JeremiahWu/RoboWheels/ros2_ws/src/robowheels_description/meshes/base_link.stl

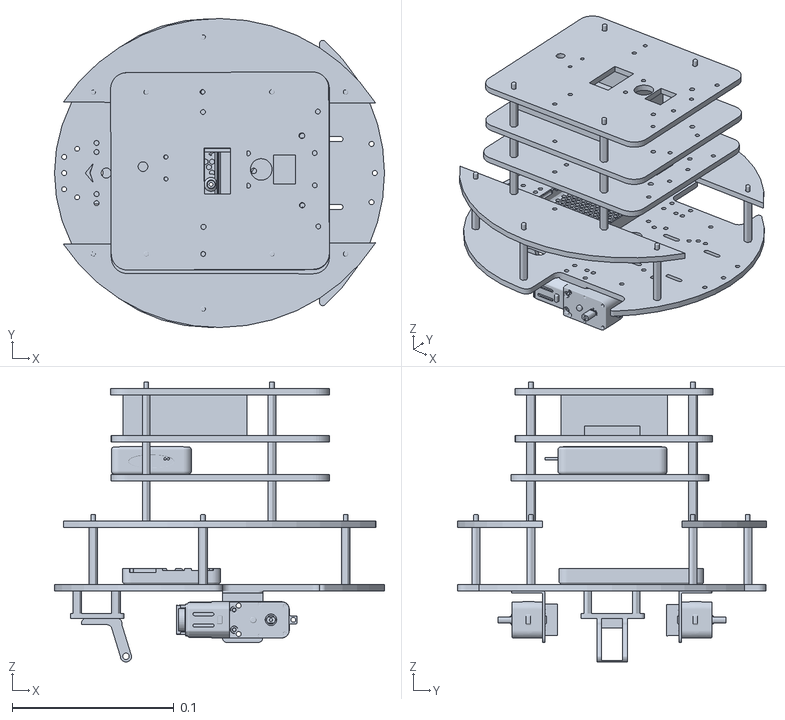
[picture p2: CAD file, 2026-11-05]
ros2_ws/src/robowheels_description/meshes/base_link.stl
0.204 x 0.191 x 0.173
