JeremiahWu/RoboWheels/ros2_ws/src/robowheels_description/meshes/arm_mount_link.stl

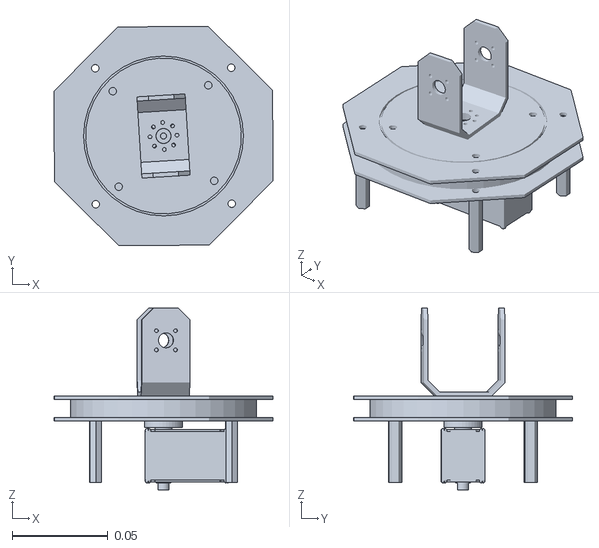
[picture p3: CAD file, 2026-11-05]
ros2_ws/src/robowheels_description/meshes/arm_mount_link.stl
0.114 x 0.114 x 0.0948
