JeremiahWu/RoboWheels/ros2_ws/src/robowheels_description/meshes/caster_link.stl

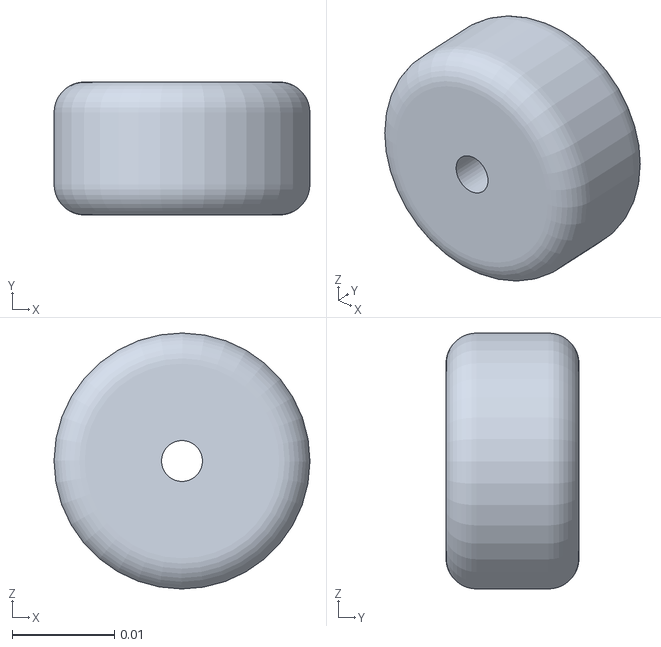
[picture p4: CAD file, 2026-11-05]
ros2_ws/src/robowheels_description/meshes/caster_link.stl
0.025 x 0.013 x 0.025
