JeremiahWu/RoboWheels/ros2_ws/src/robowheels_description/meshes/left_elbow_pitch_link.stl

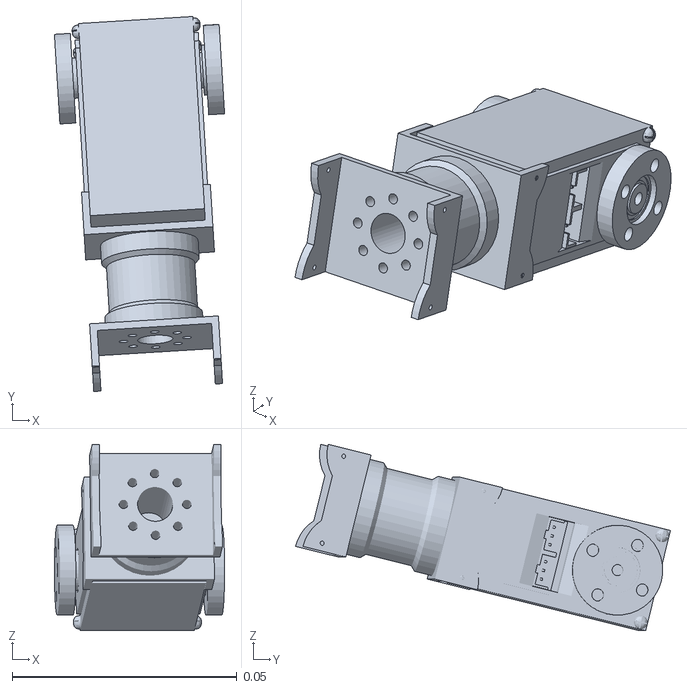
[picture p5: CAD file, 2026-11-05]
ros2_ws/src/robowheels_description/meshes/left_elbow_pitch_link.stl
0.0379 x 0.0835 x 0.0414
