JeremiahWu/RoboWheels/ros2_ws/src/robowheels_description/meshes/mast_link.stl

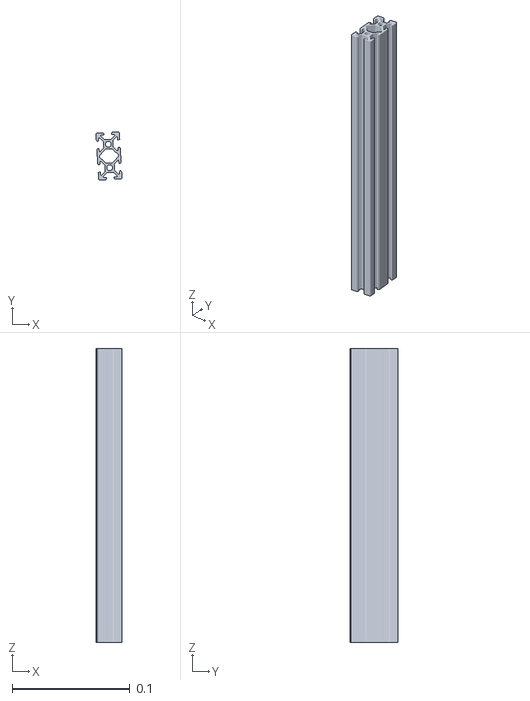
[picture p6: CAD file, 2026-11-05]
ros2_ws/src/robowheels_description/meshes/mast_link.stl
0.0223 x 0.041 x 0.25
