JeremiahWu/RoboWheels/ros2_ws/src/robowheels_description/meshes/right_wheel_link.stl

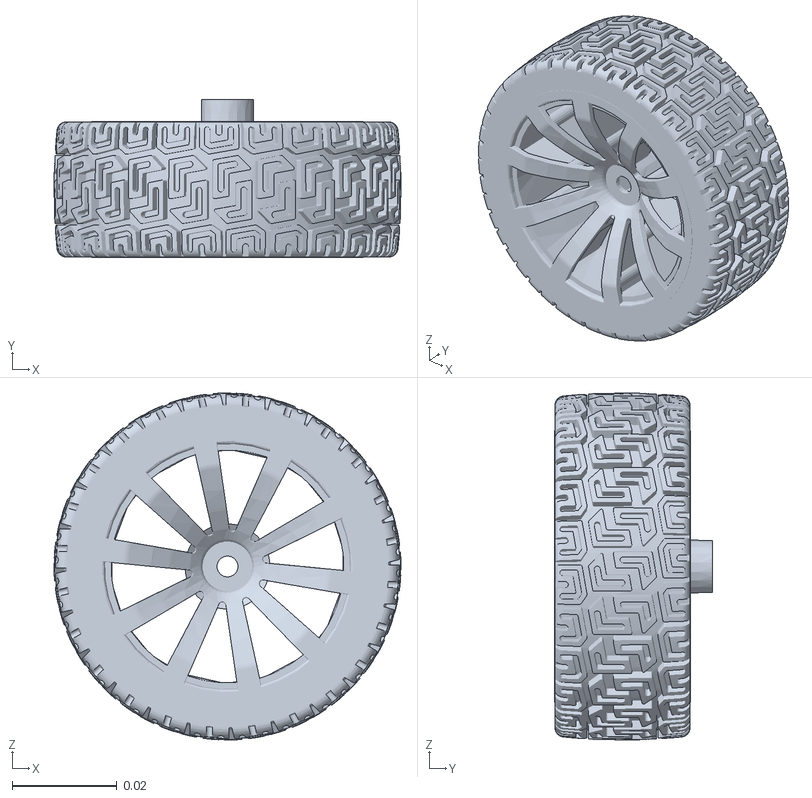
[picture p7: CAD file, 2026-11-05]
ros2_ws/src/robowheels_description/meshes/right_wheel_link.stl
0.0664 x 0.0302 x 0.0664
