JeremiahWu/RoboWheels/ros2_ws/src/robowheels_description/meshes/right_wrist_pitch_link.stl

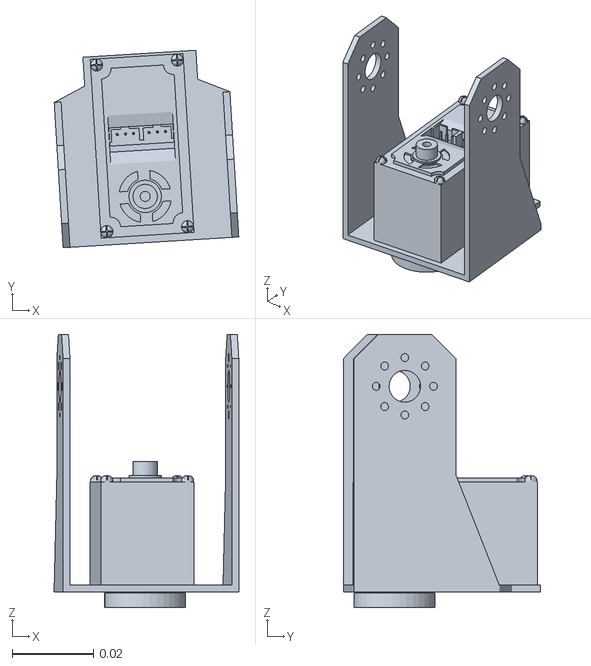
[picture p8: CAD file, 2026-11-05]
ros2_ws/src/robowheels_description/meshes/right_wrist_pitch_link.stl
0.0455 x 0.0487 x 0.0673
