JeremiahWu/RoboWheels/ros2_ws/src/robowheels_description/meshes/right_shoulder_roll_link.stl

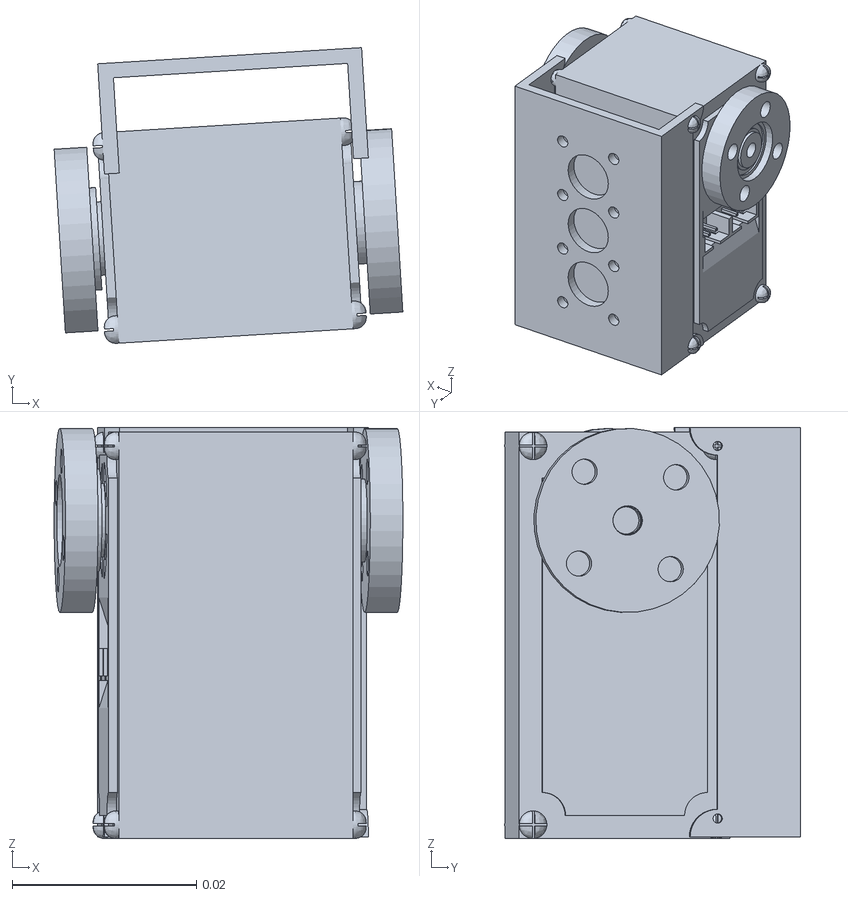
[picture p9: CAD file, 2026-11-05]
ros2_ws/src/robowheels_description/meshes/right_shoulder_roll_link.stl
0.0379 x 0.0321 x 0.0447
