JeremiahWu/RoboWheels/ros2_ws/src/robowheels_description/meshes/left_arm_link.stl

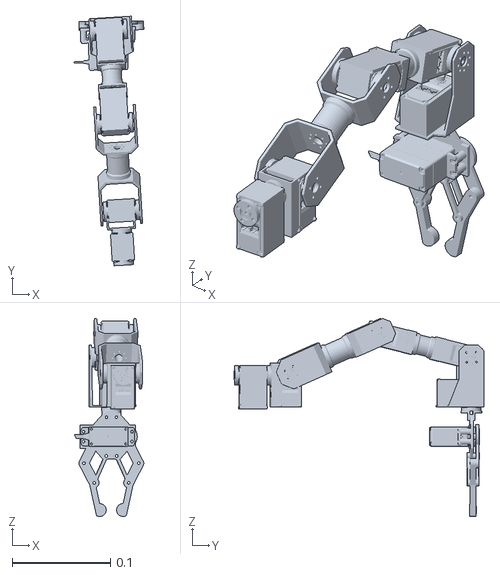
[picture p10: CAD file, 2026-11-05]
ros2_ws/src/robowheels_description/meshes/left_arm_link.stl
0.071 x 0.254 x 0.202
