JeremiahWu/RoboWheels/ros2_ws/src/robowheels_description/meshes/astra_link.stl

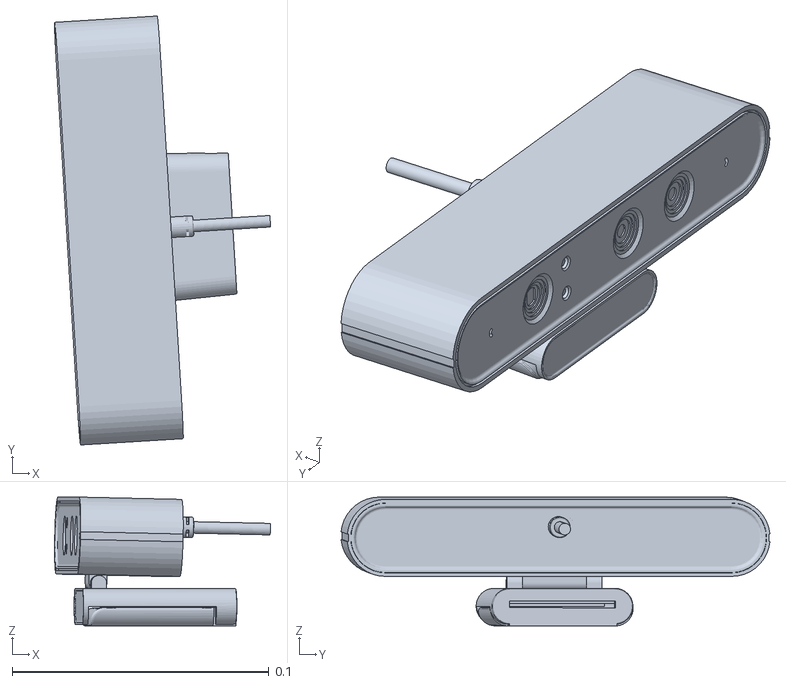
[picture p11: CAD file, 2026-11-05]
ros2_ws/src/robowheels_description/meshes/astra_link.stl
0.0841 x 0.167 x 0.0502
