JeremiahWu/RoboWheels/ros2_ws/src/robowheels_description/meshes/right_wrist_roll_link.stl

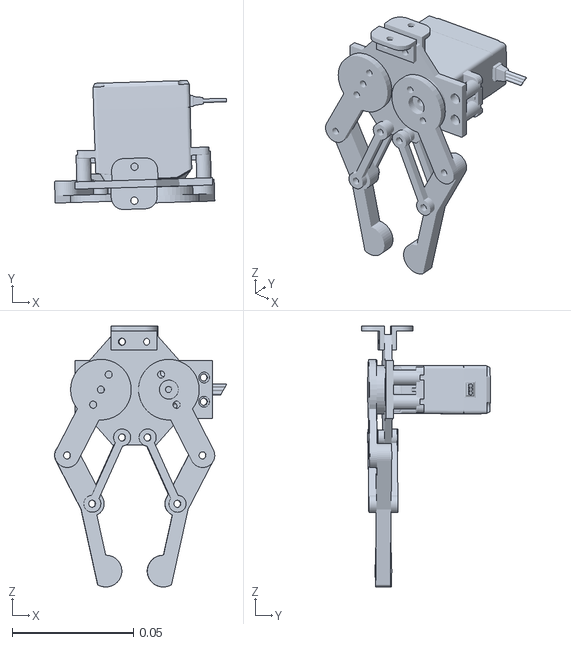
[picture p12: CAD file, 2026-11-05]
ros2_ws/src/robowheels_description/meshes/right_wrist_roll_link.stl
0.071 x 0.0532 x 0.108
