JeremiahWu/RoboWheels/ros2_ws/src/robowheels_description/meshes/left_shoulder_pitch_link.stl

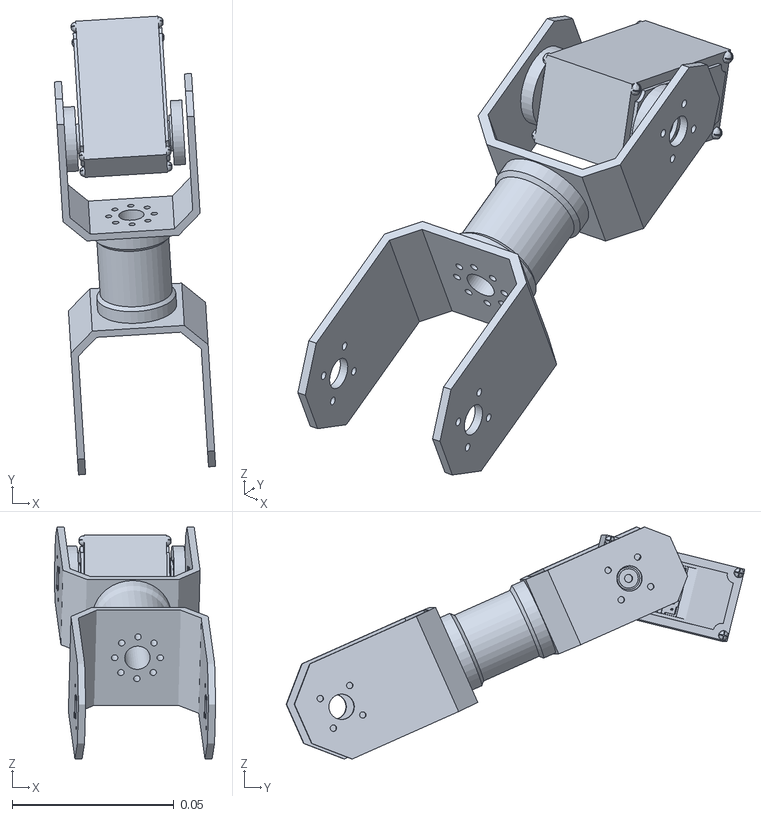
[picture p13: CAD file, 2026-11-05]
ros2_ws/src/robowheels_description/meshes/left_shoulder_pitch_link.stl
0.0499 x 0.142 x 0.0717
