JeremiahWu/RoboWheels/ros2_ws/src/robowheels_description/meshes/shoulder_housings_link.stl

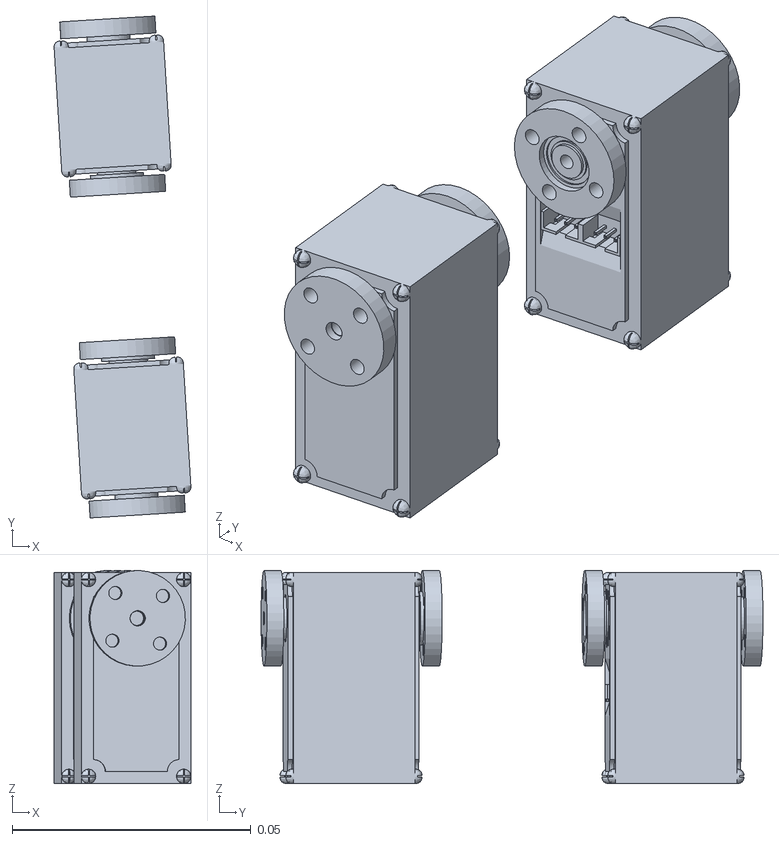
[picture p14: CAD file, 2026-11-05]
ros2_ws/src/robowheels_description/meshes/shoulder_housings_link.stl
0.0286 x 0.105 x 0.0446
