JeremiahWu/RoboWheels/(list of files, cad)

Other CAD files:
ros2_ws/src/robowheels_description/meshes/right_elbow_pitch_link.stl
ros2_ws/src/robowheels_description/meshes/left_wrist_pitch_link.stl
ros2_ws/src/robowheels_description/meshes/left_wrist_roll_link.stl
ros2_ws/src/robowheels_description/meshes/left_wheel_link.stl
ros2_ws/src/robowheels_description/meshes/right_shoulder_pitch_link.stl
ros2_ws/src/robowheels_description/meshes/left_shoulder_roll_link.stl
ros2_ws/src/robowheels_description/meshes/right_arm_link.stl
