JeremiahWu/RoboWheels/ros2_ws/src/robowheels_description/urdf/robot.sdf

<?xml version='1.0' encoding='utf-8'?>
<sdf version="1.9">
  <model name="robowheels">
    <link name="base_footprint">
      <inertial>
        <pose>-0.01786885333849206 0.001435441879079369 0.2251637846261905 0 0 0</pose>
        <mass>3.7799999999999998</mass>
        <inertia>
          <ixx>0.121327478935251</ixx>
          <ixy>0.0026274709799714458</ixy>
          <ixz>-0.0078314570425474274</ixz>
          <iyy>0.092691720102476158</iyy>
          <iyz>-0.00069924493382175355</iyz>
          <izz>0.045640601307076777</izz>
        </inertia>
      </inertial>
      <collision name="base_footprint_fixed_joint_lump__base_link_collision_collision">
        <pose>-0.0318259535 3.65871519e-05 0.0936680357 0 0 0</pose>
        <geometry>
          <box>
            <size>0.204 0.191015 0.173</size>
          </box>
        </geometry>
        <surface>
          <contact>
            <ode />
          </contact>
          <friction>
            <ode>
              <mu>0.80000000000000004</mu>
              <mu2>0.80000000000000004</mu2>
            </ode>
          </friction>
        </surface>
      </collision>
      <collision name="base_footprint_fixed_joint_lump__arm_mount_link_collision_collision_1">
        <pose>-0.00637300074 0.0023598377 0.219723035 0 0 0</pose>
        <geometry>
          <box>
            <size>0.114373 0.114373 0.09481</size>
          </box>
        </geometry>
        <surface>
          <contact>
            <ode />
          </contact>
          <friction>
            <ode>
              <mu>0.80000000000000004</mu>
              <mu2>0.80000000000000004</mu2>
            </ode>
          </friction>
        </surface>
      </collision>
      <collision name="base_footprint_fixed_joint_lump__astra_link_collision_collision_2">
        <pose>0.00857200063 0.00332180294 0.49856978 0 0 0</pose>
        <geometry>
          <box>
            <size>0.084083 0.166992 0.050164</size>
          </box>
        </geometry>
        <surface>
          <contact>
            <ode />
          </contact>
          <friction>
            <ode>
              <mu>0.80000000000000004</mu>
              <mu2>0.80000000000000004</mu2>
            </ode>
          </friction>
        </surface>
      </collision>
      <collision name="base_footprint_fixed_joint_lump__caster_link_collision_collision_3">
        <pose>-0.08965176010000001 0.00013640945 0.01249999998 0 0 0</pose>
        <geometry>
          <sphere>
            <radius>0.012500000000000001</radius>
          </sphere>
        </geometry>
        <surface>
          <contact>
            <ode />
          </contact>
          <friction>
            <ode>
              <mu>0.01</mu>
              <mu2>0.01</mu2>
            </ode>
          </friction>
        </surface>
      </collision>
      <collision name="base_footprint_fixed_joint_lump__left_arm_link_collision_collision_4">
        <pose>-0.0219609873 0.144534971 0.345362959 0 0 0</pose>
        <geometry>
          <box>
            <size>0.070983 0.254439 0.2018</size>
          </box>
        </geometry>
        <surface>
          <contact>
            <ode />
          </contact>
          <friction>
            <ode>
              <mu>0.80000000000000004</mu>
              <mu2>0.80000000000000004</mu2>
            </ode>
          </friction>
        </surface>
      </collision>
      <collision name="base_footprint_fixed_joint_lump__mast_link_collision_collision_5">
        <pose>-0.00625268749 0.00269514236 0.348488035 0 0 0</pose>
        <geometry>
          <box>
            <size>0.022292 0.04103 0.25</size>
          </box>
        </geometry>
        <surface>
          <contact>
            <ode />
          </contact>
          <friction>
            <ode>
              <mu>0.80000000000000004</mu>
              <mu2>0.80000000000000004</mu2>
            </ode>
          </friction>
        </surface>
      </collision>
      <collision name="base_footprint_fixed_joint_lump__right_arm_link_collision_collision_6">
        <pose>0.0098113317 -0.139122875 0.345362959 0 0 0</pose>
        <geometry>
          <box>
            <size>0.070983 0.254439 0.2018</size>
          </box>
        </geometry>
        <surface>
          <contact>
            <ode />
          </contact>
          <friction>
            <ode>
              <mu>0.80000000000000004</mu>
              <mu2>0.80000000000000004</mu2>
            </ode>
          </friction>
        </surface>
      </collision>
      <visual name="base_footprint_fixed_joint_lump__base_link_visual">
        <pose>0 0 0.0332 0 0 0</pose>
        <geometry>
          <mesh>
            <scale>1 1 1</scale>
            <uri>model://robowheels_description/meshes/base_link.stl</uri>
          </mesh>
        </geometry>
        <material>
          <diffuse>0.8125 0.875 0.9375 1</diffuse>
          <ambient>0.8125 0.875 0.9375 1</ambient>
        </material>
      </visual>
      <visual name="base_footprint_fixed_joint_lump__arm_mount_link_visual_1">
        <pose>-0.00637300074 0.0023598377 0.219723035 0 0 0</pose>
        <geometry>
          <mesh>
            <scale>1 1 1</scale>
            <uri>model://robowheels_description/meshes/arm_mount_link.stl</uri>
          </mesh>
        </geometry>
        <material>
          <diffuse>0.8125 0.875 0.9375 1</diffuse>
          <ambient>0.8125 0.875 0.9375 1</ambient>
        </material>
      </visual>
      <visual name="base_footprint_fixed_joint_lump__astra_link_visual_2">
        <pose>0.00857200063 0.00332180294 0.49856978 0 0 0</pose>
        <geometry>
          <mesh>
            <scale>1 1 1</scale>
            <uri>model://robowheels_description/meshes/astra_link.stl</uri>
          </mesh>
        </geometry>
        <material>
          <diffuse>0.8125 0.875 0.9375 1</diffuse>
          <ambient>0.8125 0.875 0.9375 1</ambient>
        </material>
      </visual>
      <visual name="base_footprint_fixed_joint_lump__caster_link_visual_3">
        <pose>-0.08965176010000001 0.00013640945 0.0106680359 0 0 0</pose>
        <geometry>
          <mesh>
            <scale>1 1 1</scale>
            <uri>model://robowheels_description/meshes/caster_link.stl</uri>
          </mesh>
        </geometry>
        <material>
          <diffuse>0.8125 0.875 0.9375 1</diffuse>
          <ambient>0.8125 0.875 0.9375 1</ambient>
        </material>
      </visual>
      <visual name="base_footprint_fixed_joint_lump__left_arm_link_visual_4">
        <pose>-0.0219609873 0.144534971 0.345362959 0 0 0</pose>
        <geometry>
          <mesh>
            <scale>1 1 1</scale>
            <uri>model://robowheels_description/meshes/left_arm_link.stl</uri>
          </mesh>
        </geometry>
        <material>
          <diffuse>0.8125 0.875 0.9375 1</diffuse>
          <ambient>0.8125 0.875 0.9375 1</ambient>
        </material>
      </visual>
      <visual name="base_footprint_fixed_joint_lump__mast_link_visual_5">
        <pose>-0.00625268749 0.00269514236 0.348488035 0 0 0</pose>
        <geometry>
          <mesh>
            <scale>1 1 1</scale>
            <uri>model://robowheels_description/meshes/mast_link.stl</uri>
          </mesh>
        </geometry>
        <material>
          <diffuse>0.8125 0.875 0.9375 1</diffuse>
          <ambient>0.8125 0.875 0.9375 1</ambient>
        </material>
      </visual>
      <visual name="base_footprint_fixed_joint_lump__right_arm_link_visual_6">
        <pose>0.0098113317 -0.139122875 0.345362959 0 0 0</pose>
        <geometry>
          <mesh>
            <scale>1 1 1</scale>
            <uri>model://robowheels_description/meshes/right_arm_link.stl</uri>
          </mesh>
        </geometry>
        <material>
          <diffuse>0.8125 0.875 0.9375 1</diffuse>
          <ambient>0.8125 0.875 0.9375 1</ambient>
        </material>
      </visual>
    </link>
    <joint name="left_wheel_joint" type="revolute">
      <pose relative_to="base_footprint">0 0.0781561955 0.0332 0 0 0</pose>
      <parent>base_footprint</parent>
      <child>left_wheel_link</child>
      <axis>
        <xyz>0 1 0</xyz>
        <limit>
          <effort>2</effort>
          <velocity>20</velocity>
          <lower>-10000000000000000</lower>
          <upper>10000000000000000</upper>
        </limit>
        <dynamics>
          <damping>0.01</damping>
          <friction>0</friction>
          <spring_reference>0</spring_reference>
          <spring_stiffness>0</spring_stiffness>
        </dynamics>
      </axis>
    </joint>
    <link name="left_wheel_link">
      <pose relative_to="left_wheel_joint">0 0 0 0 0 0</pose>
      <inertial>
        <pose>-3.6370024e-10 -0.000586149315 1.99372303e-10 0 0 0</pose>
        <mass>0.080000000000000002</mass>
        <inertia>
          <ixx>3.5456330816517193e-05</ixx>
          <ixy>0</ixy>
          <ixz>0</ixz>
          <iyy>5.8719812896416519e-05</iyy>
          <iyz>0</iyz>
          <izz>3.5456330816521293e-05</izz>
        </inertia>
      </inertial>
      <collision name="left_wheel_link_collision_collision">
        <pose>0 0 0 1.570796326794896 0 0</pose>
        <geometry>
          <cylinder>
            <length>0.025999999999999999</length>
            <radius>0.0332</radius>
          </cylinder>
        </geometry>
        <surface>
          <contact>
            <ode />
          </contact>
          <friction>
            <ode>
              <mu>0.80000000000000004</mu>
              <mu2>0.80000000000000004</mu2>
            </ode>
          </friction>
        </surface>
      </collision>
      <visual name="left_wheel_link_visual">
        <pose>0 0 0 0 0 0</pose>
        <geometry>
          <mesh>
            <scale>1 1 1</scale>
            <uri>model://robowheels_description/meshes/left_wheel_link.stl</uri>
          </mesh>
        </geometry>
        <material>
          <diffuse>0.15 0.15 0.175 1</diffuse>
          <ambient>0.15 0.15 0.175 1</ambient>
        </material>
      </visual>
    </link>
    <joint name="right_wheel_joint" type="revolute">
      <pose relative_to="base_footprint">0 -0.0781561955 0.0332 0 0 0</pose>
      <parent>base_footprint</parent>
      <child>right_wheel_link</child>
      <axis>
        <xyz>0 1 0</xyz>
        <limit>
          <effort>2</effort>
          <velocity>20</velocity>
          <lower>-10000000000000000</lower>
          <upper>10000000000000000</upper>
        </limit>
        <dynamics>
          <damping>0.01</damping>
          <friction>0</friction>
          <spring_reference>0</spring_reference>
          <spring_stiffness>0</spring_stiffness>
        </dynamics>
      </axis>
    </joint>
    <link name="right_wheel_link">
      <pose relative_to="right_wheel_joint">0 0 0 0 0 0</pose>
      <inertial>
        <pose>2.94291862e-10 0.000586141681 2.00216441e-10 0 0 0</pose>
        <mass>0.080000000000000002</mass>
        <inertia>
          <ixx>3.5456330816527818e-05</ixx>
          <ixy>0</ixy>
          <ixz>0</ixz>
          <iyy>5.8719812896417197e-05</iyy>
          <iyz>0</iyz>
          <izz>3.5456330816524721e-05</izz>
        </inertia>
      </inertial>
      <collision name="right_wheel_link_collision_collision">
        <pose>0 0 0 1.570796326794896 0 0</pose>
        <geometry>
          <cylinder>
            <length>0.025999999999999999</length>
            <radius>0.0332</radius>
          </cylinder>
        </geometry>
        <surface>
          <contact>
            <ode />
          </contact>
          <friction>
            <ode>
              <mu>0.80000000000000004</mu>
              <mu2>0.80000000000000004</mu2>
            </ode>
          </friction>
        </surface>
      </collision>
      <visual name="right_wheel_link_visual">
        <pose>0 0 0 0 0 0</pose>
        <geometry>
          <mesh>
            <scale>1 1 1</scale>
            <uri>model://robowheels_description/meshes/right_wheel_link.stl</uri>
          </mesh>
        </geometry>
        <material>
          <diffuse>0.15 0.15 0.175 1</diffuse>
          <ambient>0.15 0.15 0.175 1</ambient>
        </material>
      </visual>
    </link>
    <plugin name="ignition::gazebo::systems::DiffDrive" filename="libignition-gazebo-diff-drive-system.so">
      <left_joint>left_wheel_joint</left_joint>
      <right_joint>right_wheel_joint</right_joint>
      <wheel_separation>0.15631239107433037</wheel_separation>
      <wheel_radius>0.0332</wheel_radius>
      <topic>/sim/cmd_vel</topic>
      <odom_topic>/odom</odom_topic>
      <tf_topic>/tf</tf_topic>
      <frame_id>odom</frame_id>
      <child_frame_id>base_footprint</child_frame_id>
      <odom_publish_frequency>50</odom_publish_frequency>
      <max_linear_velocity>0.5</max_linear_velocity>
      <min_linear_velocity>-0.5</min_linear_velocity>
      <max_angular_velocity>2.0</max_angular_velocity>
      <min_angular_velocity>-2.0</min_angular_velocity>
    </plugin>
    <plugin name="ignition::gazebo::systems::JointStatePublisher" filename="libignition-gazebo-joint-state-publisher-system.so">
      <topic>/joint_states</topic>
      <joint_name>left_wheel_joint</joint_name>
      <joint_name>right_wheel_joint</joint_name>
    </plugin>
    <plugin name="ignition::gazebo::systems::PosePublisher" filename="libignition-gazebo-pose-publisher-system.so">
      <publish_model_pose>true</publish_model_pose>
      <publish_link_pose>false</publish_link_pose>
      <use_pose_vector_msg>true</use_pose_vector_msg>
      <update_frequency>30</update_frequency>
      <publish_nested_model_pose>true</publish_nested_model_pose>
    </plugin>
    <frame name="arm_mount_joint" attached_to="base_link">
      <pose>-0.006373 0.00236 0.186523 0 -0 0</pose>
    </frame>
    <frame name="arm_mount_link" attached_to="arm_mount_joint" />
    <frame name="astra_joint" attached_to="base_link">
      <pose>0.008572 0.003322 0.46537 0 -0 0</pose>
    </frame>
    <frame name="astra_link" attached_to="astra_joint" />
    <frame name="caster_joint" attached_to="base_link">
      <pose>-0.089652 0.000136 -0.022532 0 -0 0</pose>
    </frame>
    <frame name="caster_link" attached_to="caster_joint" />
    <frame name="left_arm_joint" attached_to="base_link">
      <pose>-0.021961 0.144535 0.312163 0 -0 0</pose>
    </frame>
    <frame name="left_arm_link" attached_to="left_arm_joint" />
    <frame name="mast_joint" attached_to="base_link">
      <pose>-0.006253 0.002695 0.315288 0 -0 0</pose>
    </frame>
    <frame name="mast_link" attached_to="mast_joint" />
    <frame name="right_arm_joint" attached_to="base_link">
      <pose>0.009811 -0.139123 0.312163 0 -0 0</pose>
    </frame>
    <frame name="right_arm_link" attached_to="right_arm_joint" />
    <frame name="base_footprint_joint" attached_to="base_footprint">
      <pose>0 0 0.0332 0 -0 0</pose>
    </frame>
    <frame name="base_link" attached_to="base_footprint_joint" />
  </model>
</sdf>
