JeremiahWu/RoboWheels/ros2_ws/src/robowheels_description/urdf/robot.urdf

<?xml version='1.0' encoding='utf-8'?>
<robot name="robowheels">
  <link name="base_footprint" />
  <joint name="base_footprint_joint" type="fixed">
    <parent link="base_footprint" />
    <child link="base_link" />
    <origin xyz="0 0 0.0332" />
  </joint>
  <link name="base_link">
    <visual>
      <geometry>
        <mesh filename="package://robowheels_description/meshes/base_link.stl" />
      </geometry>
      <material name="base_link_material">
        <color rgba="0.65 0.7 0.75 1" />
      </material>
    </visual>
    <inertial>
      <origin xyz="-0.0318259535 3.65871519e-05 0.0604680357" />
      <mass value="1.8" />
      <inertia ixx="0.00996234786066134" iyy="0.010731749977905014" izz="0.011715397882756337" ixy="0" ixz="0" iyz="0" />
    </inertial>
    <collision name="base_link_collision">
      <origin xyz="-0.0318259535 3.65871519e-05 0.0604680357" />
      <geometry>
        <box size="0.204 0.191014797 0.173" />
      </geometry>
    </collision>
  </link>
  <gazebo reference="base_link">
    <mu1>0.8</mu1>
    <mu2>0.8</mu2>
  </gazebo>
  <link name="mast_link">
    <visual>
      <geometry>
        <mesh filename="package://robowheels_description/meshes/mast_link.stl" />
      </geometry>
      <material name="mast_link_material">
        <color rgba="0.65 0.7 0.75 1" />
      </material>
    </visual>
    <inertial>
      <origin xyz="0 0 0" />
      <mass value="0.15" />
      <inertia ixx="0.0008022936571966947" iyy="0.0007874616086122587" izz="2.7255265808507982e-05" ixy="0" ixz="0" iyz="0" />
    </inertial>
    <collision name="mast_link_collision">
      <origin xyz="0 0 0" />
      <geometry>
        <box size="0.0222918974 0.041030386 0.25" />
      </geometry>
    </collision>
  </link>
  <joint name="mast_joint" type="fixed">
    <parent link="base_link" />
    <child link="mast_link" />
    <origin xyz="-0.00625268749 0.00269514236 0.315288035" />
  </joint>
  <gazebo reference="mast_link">
    <mu1>0.8</mu1>
    <mu2>0.8</mu2>
  </gazebo>
  <link name="arm_mount_link">
    <visual>
      <geometry>
        <mesh filename="package://robowheels_description/meshes/arm_mount_link.stl" />
      </geometry>
      <material name="arm_mount_link_material">
        <color rgba="0.65 0.7 0.75 1" />
      </material>
    </visual>
    <inertial>
      <origin xyz="0 0 0" />
      <mass value="0.3" />
      <inertia ixx="0.000551753377151742" iyy="0.0005517533771518032" izz="0.0006540599493033816" ixy="0" ixz="0" iyz="0" />
    </inertial>
    <collision name="arm_mount_link_collision">
      <origin xyz="0 0 0" />
      <geometry>
        <box size="0.114373069 0.114373069 0.09481" />
      </geometry>
    </collision>
  </link>
  <joint name="arm_mount_joint" type="fixed">
    <parent link="base_link" />
    <child link="arm_mount_link" />
    <origin xyz="-0.00637300074 0.0023598377 0.186523035" />
  </joint>
  <gazebo reference="arm_mount_link">
    <mu1>0.8</mu1>
    <mu2>0.8</mu2>
  </gazebo>
  <link name="right_arm_link">
    <visual>
      <geometry>
        <mesh filename="package://robowheels_description/meshes/right_arm_link.stl" />
      </geometry>
      <material name="right_arm_link_material">
        <color rgba="0.65 0.7 0.75 1" />
      </material>
    </visual>
    <inertial>
      <origin xyz="0 0 0" />
      <mass value="0.6" />
      <inertia ixx="0.005273131365345715" iyy="0.002288099321798799" izz="0.003488890433555441" ixy="0" ixz="0" iyz="0" />
    </inertial>
    <collision name="right_arm_link_collision">
      <origin xyz="0 0 0" />
      <geometry>
        <box size="0.0709829832 0.254439039 0.201800403" />
      </geometry>
    </collision>
  </link>
  <joint name="right_arm_joint" type="fixed">
    <parent link="base_link" />
    <child link="right_arm_link" />
    <origin xyz="0.0098113317 -0.139122875 0.312162959" />
  </joint>
  <gazebo reference="right_arm_link">
    <mu1>0.8</mu1>
    <mu2>0.8</mu2>
  </gazebo>
  <link name="left_arm_link">
    <visual>
      <geometry>
        <mesh filename="package://robowheels_description/meshes/left_arm_link.stl" />
      </geometry>
      <material name="left_arm_link_material">
        <color rgba="0.65 0.7 0.75 1" />
      </material>
    </visual>
    <inertial>
      <origin xyz="0 0 0" />
      <mass value="0.6" />
      <inertia ixx="0.005273131365348482" iyy="0.002288099321798492" izz="0.0034888904335580585" ixy="0" ixz="0" iyz="0" />
    </inertial>
    <collision name="left_arm_link_collision">
      <origin xyz="0 0 0" />
      <geometry>
        <box size="0.0709829832 0.254439039 0.201800403" />
      </geometry>
    </collision>
  </link>
  <joint name="left_arm_joint" type="fixed">
    <parent link="base_link" />
    <child link="left_arm_link" />
    <origin xyz="-0.0219609873 0.144534971 0.312162959" />
  </joint>
  <gazebo reference="left_arm_link">
    <mu1>0.8</mu1>
    <mu2>0.8</mu2>
  </gazebo>
  <link name="astra_link">
    <visual>
      <geometry>
        <mesh filename="package://robowheels_description/meshes/astra_link.stl" />
      </geometry>
      <material name="astra_link_material">
        <color rgba="0.65 0.7 0.75 1" />
      </material>
    </visual>
    <inertial>
      <origin xyz="0 0 0" />
      <mass value="0.3" />
      <inertia ixx="0.0007600693162909078" iyy="0.0002396586653657222" izz="0.000873908195797151" ixy="0" ixz="0" iyz="0" />
    </inertial>
    <collision name="astra_link_collision">
      <origin xyz="0 0 0" />
      <geometry>
        <box size="0.0840830001 0.166992146 0.0501636892" />
      </geometry>
    </collision>
  </link>
  <joint name="astra_joint" type="fixed">
    <parent link="base_link" />
    <child link="astra_link" />
    <origin xyz="0.00857200063 0.00332180294 0.46536978" />
  </joint>
  <gazebo reference="astra_link">
    <mu1>0.8</mu1>
    <mu2>0.8</mu2>
  </gazebo>
  <link name="left_wheel_link">
    <visual>
      <geometry>
        <mesh filename="package://robowheels_description/meshes/left_wheel_link.stl" />
      </geometry>
      <material name="left_wheel_link_material">
        <color rgba="0.12 0.12 0.14 1" />
      </material>
    </visual>
    <inertial>
      <origin xyz="-3.6370024e-10 -0.000586149315 1.99372303e-10" />
      <mass value="0.08" />
      <inertia ixx="3.5456330816517186e-05" iyy="5.871981289641652e-05" izz="3.545633081652129e-05" ixy="0" ixz="0" iyz="0" />
    </inertial>
    <collision name="left_wheel_link_collision">
      <origin rpy="1.5707963267948966 0 0" />
      <geometry>
        <cylinder radius="0.0332" length="0.026" />
      </geometry>
    </collision>
  </link>
  <joint name="left_wheel_joint" type="continuous">
    <parent link="base_link" />
    <child link="left_wheel_link" />
    <origin xyz="0 0.0781561955 0" />
    <axis xyz="0 1 0" />
    <limit effort="2" velocity="20" />
    <dynamics damping="0.01" friction="0" />
  </joint>
  <gazebo reference="left_wheel_link">
    <mu1>0.8</mu1>
    <mu2>0.8</mu2>
  </gazebo>
  <link name="right_wheel_link">
    <visual>
      <geometry>
        <mesh filename="package://robowheels_description/meshes/right_wheel_link.stl" />
      </geometry>
      <material name="right_wheel_link_material">
        <color rgba="0.12 0.12 0.14 1" />
      </material>
    </visual>
    <inertial>
      <origin xyz="2.94291862e-10 0.000586141681 2.00216441e-10" />
      <mass value="0.08" />
      <inertia ixx="3.545633081652782e-05" iyy="5.8719812896417204e-05" izz="3.545633081652472e-05" ixy="0" ixz="0" iyz="0" />
    </inertial>
    <collision name="right_wheel_link_collision">
      <origin rpy="1.5707963267948966 0 0" />
      <geometry>
        <cylinder radius="0.0332" length="0.026" />
      </geometry>
    </collision>
  </link>
  <joint name="right_wheel_joint" type="continuous">
    <parent link="base_link" />
    <child link="right_wheel_link" />
    <origin xyz="0 -0.0781561955 0" />
    <axis xyz="0 1 0" />
    <limit effort="2" velocity="20" />
    <dynamics damping="0.01" friction="0" />
  </joint>
  <gazebo reference="right_wheel_link">
    <mu1>0.8</mu1>
    <mu2>0.8</mu2>
  </gazebo>
  <link name="caster_link">
    <visual>
      <geometry>
        <mesh filename="package://robowheels_description/meshes/caster_link.stl" />
      </geometry>
      <material name="caster_link_material">
        <color rgba="0.65 0.7 0.75 1" />
      </material>
    </visual>
    <inertial>
      <origin xyz="0 0 0" />
      <mass value="0.03" />
      <inertia ixx="1.9850315052214744e-06" iyy="3.125050003812256e-06" izz="1.985031508830174e-06" ixy="0" ixz="0" iyz="0" />
    </inertial>
    <collision name="caster_link_collision">
      <origin xyz="0 0 0.00183196408" />
      <geometry>
        <sphere radius="0.0125" />
      </geometry>
    </collision>
  </link>
  <joint name="caster_joint" type="fixed">
    <parent link="base_link" />
    <child link="caster_link" />
    <origin xyz="-0.0896517601 0.00013640945 -0.0225319641" />
  </joint>
  <gazebo reference="caster_link">
    <mu1>0.01</mu1>
    <mu2>0.01</mu2>
  </gazebo>
  <gazebo>
    <plugin filename="libignition-gazebo-diff-drive-system.so" name="ignition::gazebo::systems::DiffDrive">
      <left_joint>left_wheel_joint</left_joint>
      <right_joint>right_wheel_joint</right_joint>
      <wheel_separation>0.15631239107433037</wheel_separation>
      <wheel_radius>0.0332</wheel_radius>
      <topic>/sim/cmd_vel</topic>
      <odom_topic>/odom</odom_topic>
      <tf_topic>/tf</tf_topic>
      <frame_id>odom</frame_id>
      <child_frame_id>base_footprint</child_frame_id>
      <odom_publish_frequency>50</odom_publish_frequency>
      <max_linear_velocity>0.5</max_linear_velocity>
      <min_linear_velocity>-0.5</min_linear_velocity>
      <max_angular_velocity>2.0</max_angular_velocity>
      <min_angular_velocity>-2.0</min_angular_velocity>
    </plugin>
    <plugin filename="libignition-gazebo-joint-state-publisher-system.so" name="ignition::gazebo::systems::JointStatePublisher">
      <topic>/joint_states</topic>
      <joint_name>left_wheel_joint</joint_name>
      <joint_name>right_wheel_joint</joint_name>
    </plugin>
  </gazebo>
  <gazebo>
    <plugin filename="libignition-gazebo-pose-publisher-system.so" name="ignition::gazebo::systems::PosePublisher">
      <publish_model_pose>true</publish_model_pose>
      <publish_link_pose>false</publish_link_pose>
      <use_pose_vector_msg>true</use_pose_vector_msg>
      <update_frequency>30</update_frequency>
      <publish_nested_model_pose>true</publish_nested_model_pose>
    </plugin>
  </gazebo>
</robot>
