JeremiahWu/RoboWheels/(commit log)

2026-09-10 for RDKx5
    [motor.yaml]
2026-11-05 feat: 搭建机械模型仿真平台，支持浏览器 RViz、双臂轨迹与差速底盘控制
    [20.5mm Union.SLDPRT, 29mm Union.SLDPRT, BackHub .SLDPRT, Bearing.SLDPRT, C0815452404D5CF776A3CB031F1C0EB8.SLDPRT, D92F8E06EEF41729D20824EFAC26D440.SLDPRT, EndFinger.SLDPRT, FrontHub.SLDPRT]
2026-11-07 feat: 接入 XQuartz 与 VirtualGL，支持原生 RViz2 双臂轨迹与差速底盘控制
2026-11-08 add wiring.md
2026-11-08 feat: 完善 RDK X5 差速模型与手柄控制，接入编码器事件采样和远程 RViz
    [motor.yaml]
2026-11-08 feat: 接入 X5 BPU 双目深度、ORB 视觉里程计与 ESDF 规划预览
2026-11-09 feat: 接入八关节实体双臂与 RViz 联动，整理项目模块和本机配置
    [motor.yaml, servo_bridge.example.json, servo_zero_offsets.example.json]
